LiamGilbertson/MM2SE/README.md

# MM2SE
MendelMax 2.0 Syringe Extruder

The bill of materials and assembly guide can be found in the Documentation folder.

3D models, laser cut patterns and part drawings can be found in the Models folder.

Custom firmware for the optional endstop can be found in the Firmware folder.

Happy making!
