LiamGilbertson/MM2SE/Models/Part Drawings/MM2SE Lead Nut Drawing.JPG

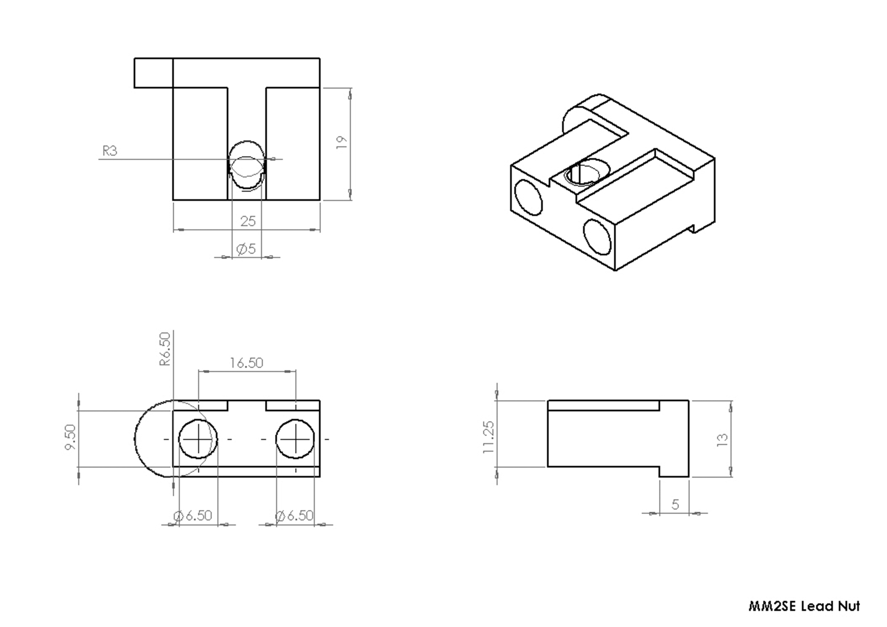
Models/Part Drawings/MM2SE Lead Nut Drawing.JPG
