LiamGilbertson/MM2SE/Models/Part Drawings/MM2SE Rods and Shafts Drawing.JPG

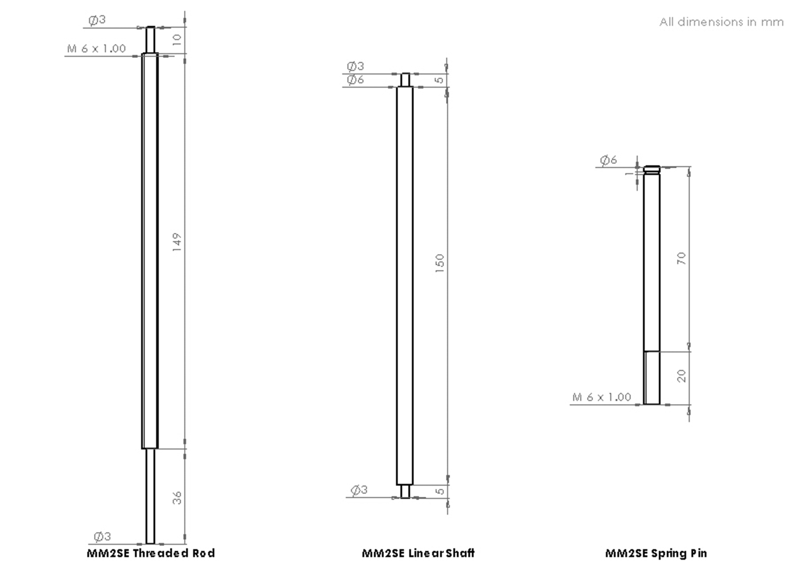
Models/Part Drawings/MM2SE Rods and Shafts Drawing.JPG
