LiamGilbertson/MM2SE/Models/Printed Parts/MM2SE Sliding Press.STL

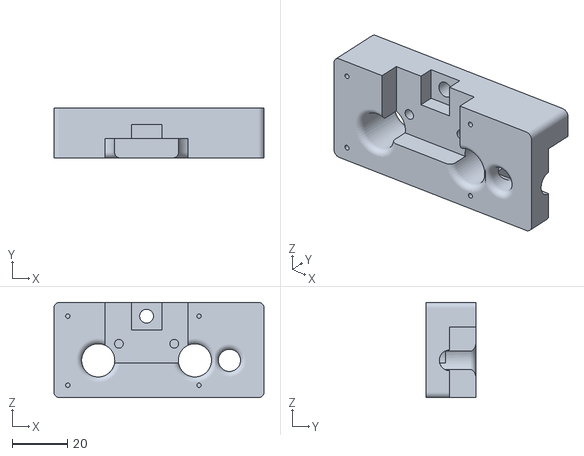
[picture p4: CAD file, 2015-02-28]
Models/Printed Parts/MM2SE Sliding Press.STL
76.0 x 18.0 x 34.5
