LiamGilbertson/MM2SE/Models/Printed Parts/MM2SE Endstop Spacer.STL

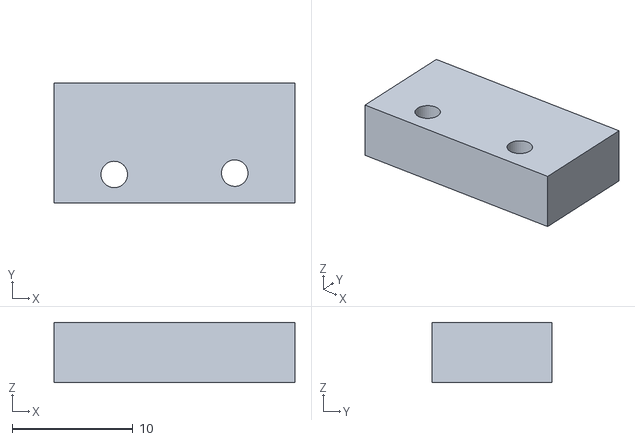
[picture p5: CAD file, 2015-02-26]
Models/Printed Parts/MM2SE Endstop Spacer.STL
20.0 x 10.0 x 5.00
