LiamGilbertson/MM2SE/Models/Printed Parts/MM2SE Spring Clamp.STL

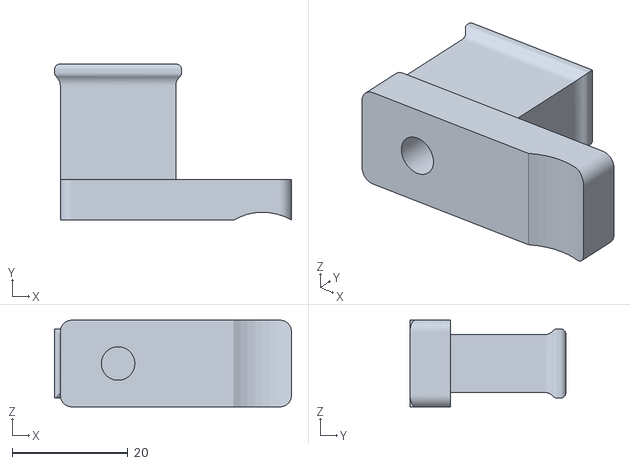
[picture p6: CAD file, 2015-02-26]
Models/Printed Parts/MM2SE Spring Clamp.STL
41.0 x 27.0 x 15.0
