LiamGilbertson/MM2SE/Models/Printed Parts/MM2SE Bottom Mount.STL

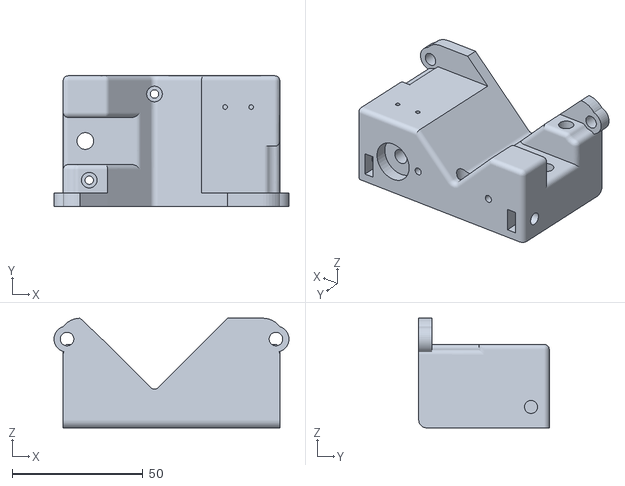
[picture p7: CAD file, 2015-02-26]
Models/Printed Parts/MM2SE Bottom Mount.STL
90.0 x 50.0 x 42.0
