LiamGilbertson/MM2SE/Models/Printed Parts/MM2SE Top Mount.STL

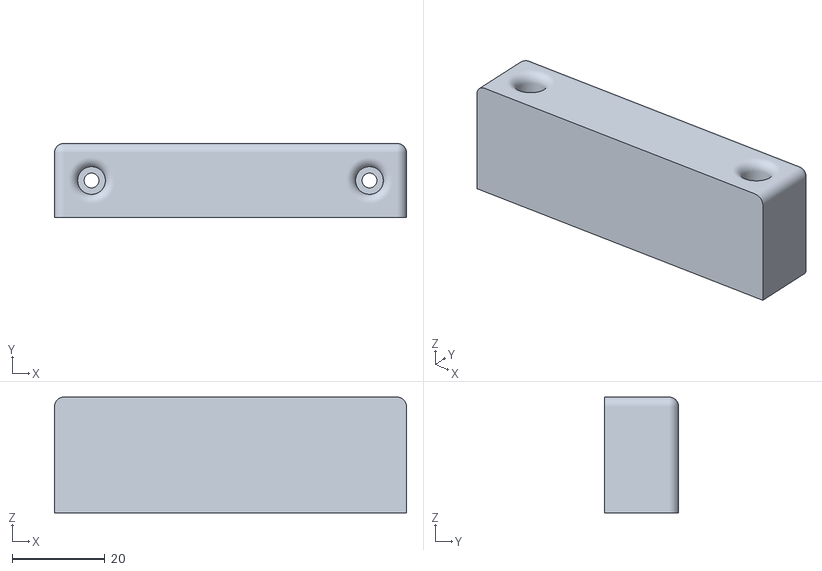
[picture p8: CAD file, 2015-02-26]
Models/Printed Parts/MM2SE Top Mount.STL
76.0 x 16.0 x 25.0
