LiamGilbertson/MM2SE/Documentation/MM2SE Assembly Guide.pdf

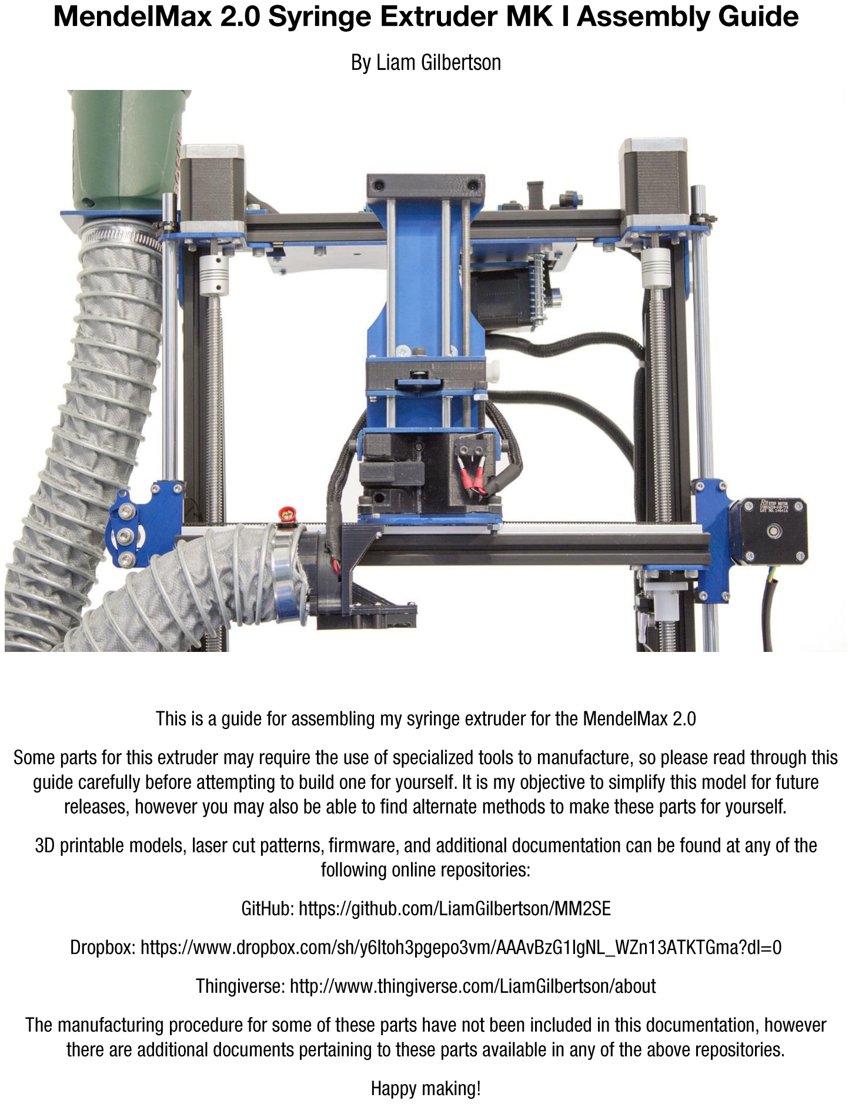
[picture p9: page 1]

Item | Qty | Notes

Water Jet \ Laser Cut Parts
MM2SE Frame | 1 | 3mm Sheet Aluminium, bent as per DXF file. Anodising preferable
MM2SE Lower Syringe Clamp | 1 | 3mm Sheet Aluminium, bent as per DXF file. Anodising preferable
MM2SE Sliding Press Bottom
Plate | 1 | 3mm Sheet Aluminium. Anodising preferable
MM2SE Sliding Press Clamp | 1 | 3mm Sheet Aluminium. Anodising preferable
MM2SE Sliding Press Top Plate | 1 | 3mm Sheet Aluminium. Anodising preferable
MM2SE Stepper Motor Mount | 1 | 3mm Sheet Aluminium, bent as per DXF file. Anodising preferable

3D Printed Parts
MM2SE Top Mount | 1
MM2SE Bottom Mount | 1
MM2SE Sliding Press | 1
MM2SE Spring Clamp | 1
MM2SE Endstop Spacer | 1 | For Optional Endstop

Electronics
Nema 17 Stepper Motor | 1 | May require additional wiring
Endstop | 1 | Optional

Motion
GT2 Pulley + Grub Screws | 2 | 20 Tooth is best, but anything that fits inside the bottom mount will do
GT2 Belt | 1 | 140-GT2 Belt
Ball Bearing | 2 | F605ZZ Flanged Bearing, can be substituted for standard bearing of same dimensions
Linear Bearing | 2 | LM6UU Linear Bearing
Linear Shaft | 3 | M6 Stainless Steel Linear Shaft - 2 x 160mm, 1 x 90mm, as per spec sheet

Threaded Rod | 1 | M6 Stainless Steel Threaded Rod, 195mm, as per spec sheet
Lead Nut | 1 | Acetyl, PTFE or other suitable engineering plastic, as per spec sheet
Compression Spring | 1 | 2in x 0.42in x 0.035in or similar
Compression Spring | 1 | 3\16in x 1-3/8in x 0.016in. Can be substituted for 2 springs half this length

Hardware
M6 External Surclip | 1
M5 x 25 Screws | 1 | For Optional Endstop
M5 x 20 Screws | 3
M5 x 12 Screws | 2
M5 x 12 Countersunk Screws | 4
M5 Washers | 24
M5 Split Washers | 4
M5 x 4 Nuts | 9 | Thickness of 4mm, to fit Lower Syringe Clamp nut traps
M5 External Surclip | 1
M3 x 20 Screws | 2
M3 x 15 Screws | 4
M3 x 8 Screws | 4
M3 x 6 Self Tapping Screws | 8 | If you can't find self-tapping screws, machine screws will do
M3 Washers | 4
M3 Nuts | 4
M2 x 12 Screws | 2 | For Optional Endstop

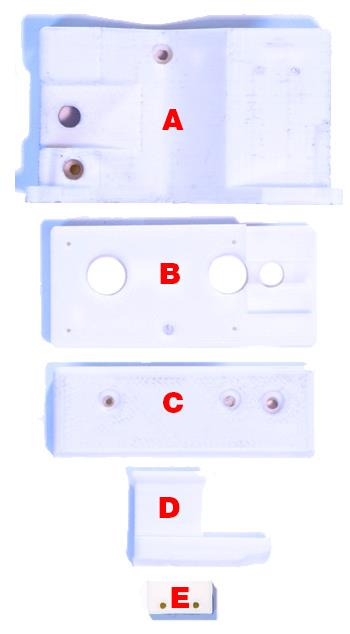
[picture p10: figure]
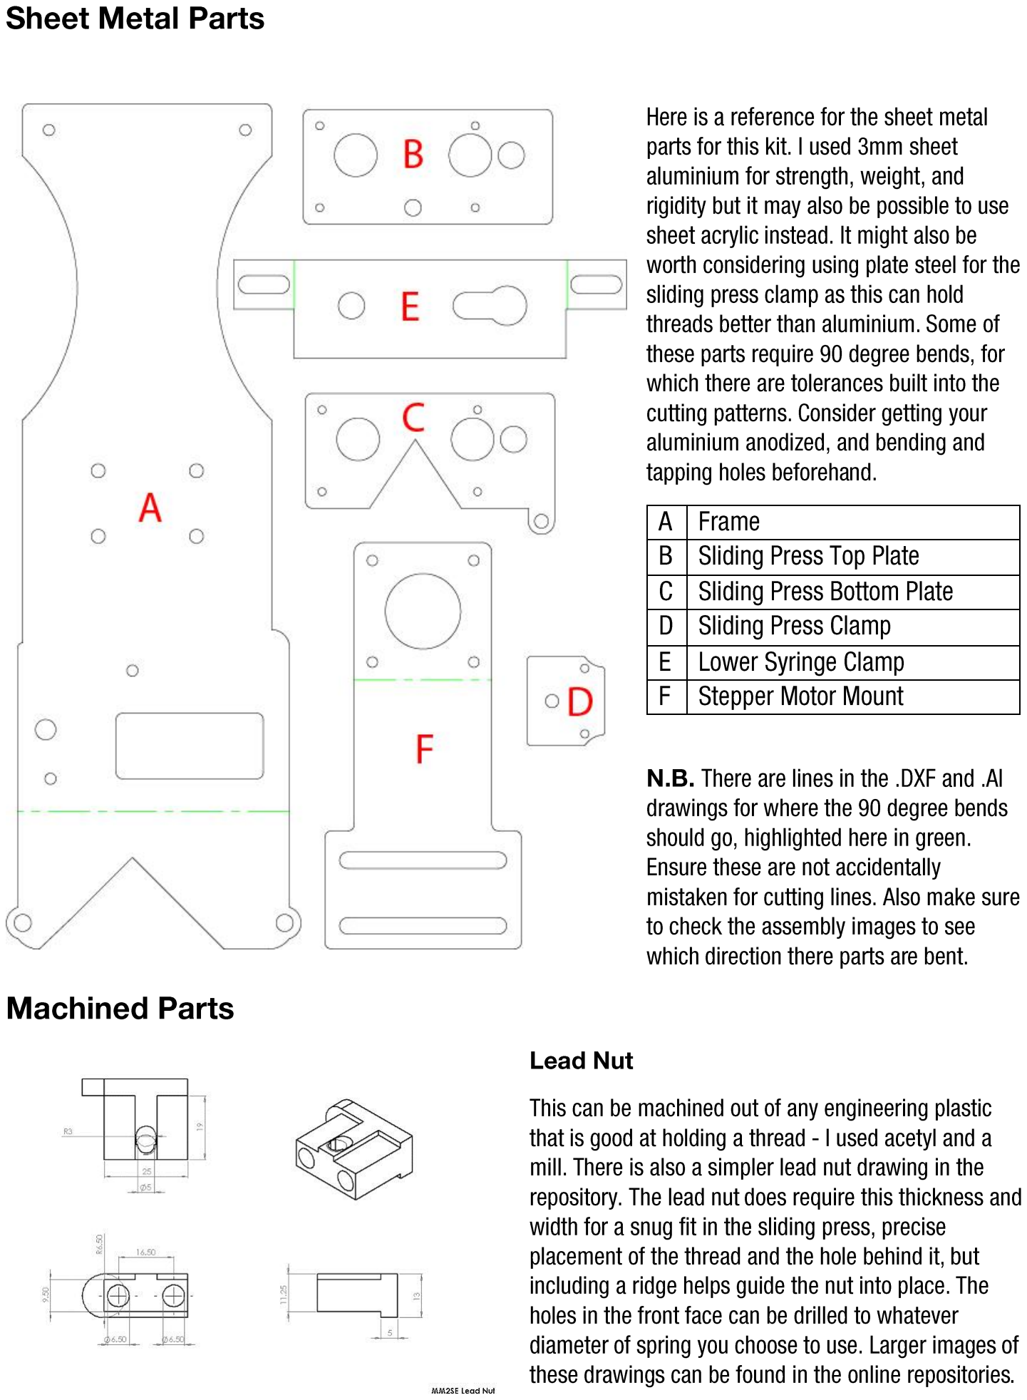
[picture p11: page 4]
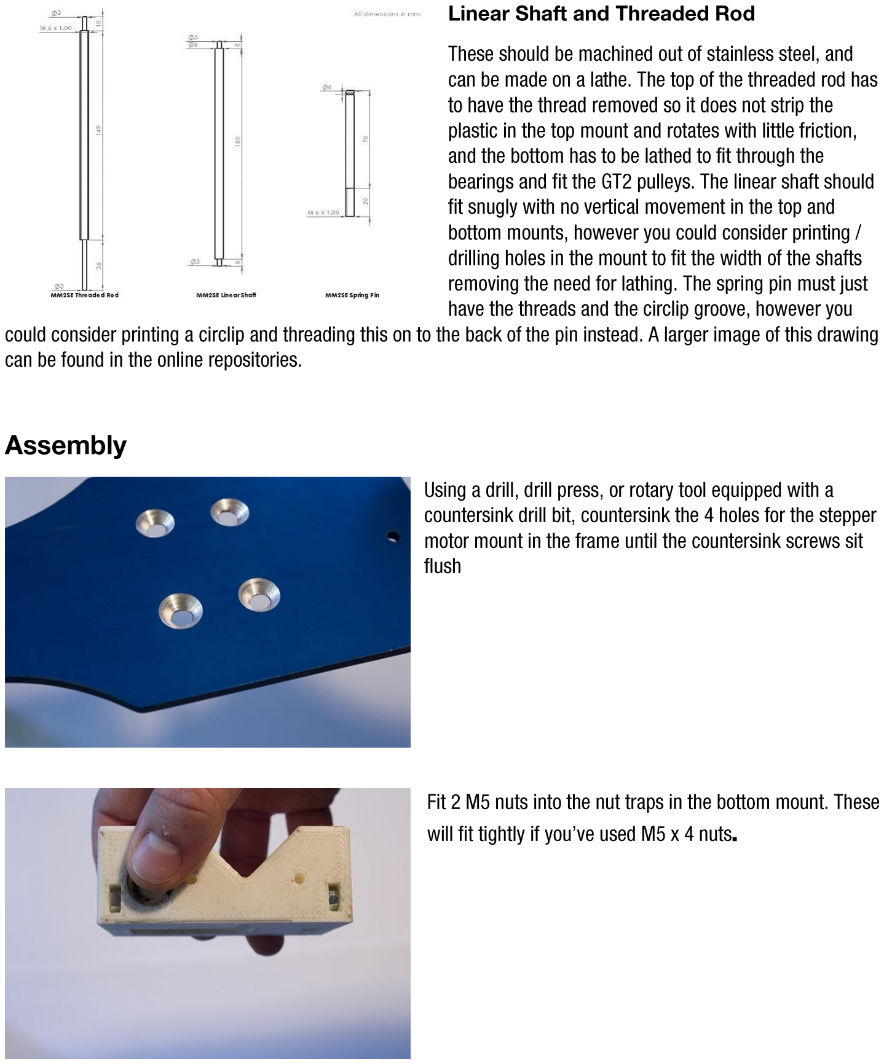
[picture p12: page 5]

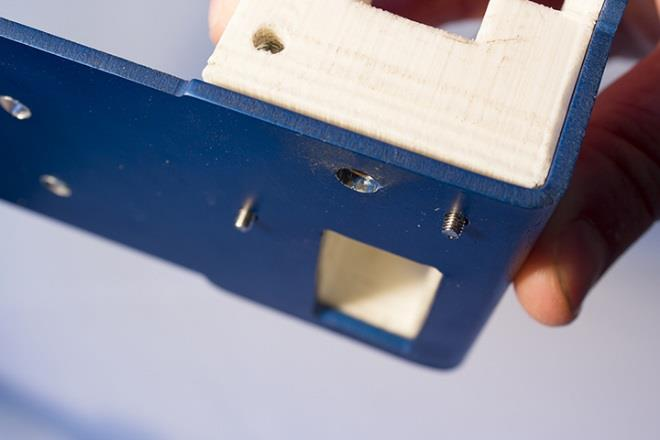
[picture p13: figure]
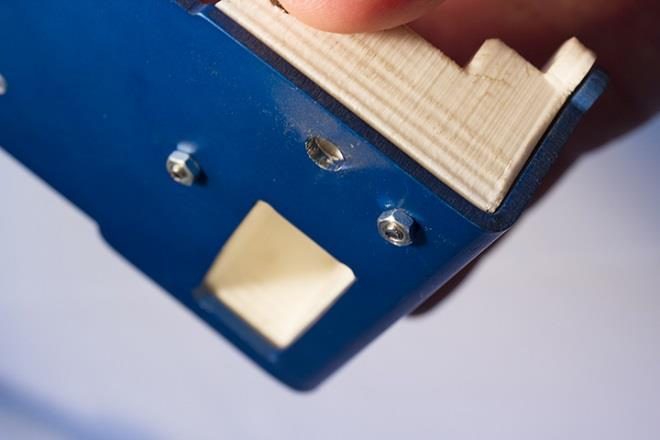
[picture p14: figure]
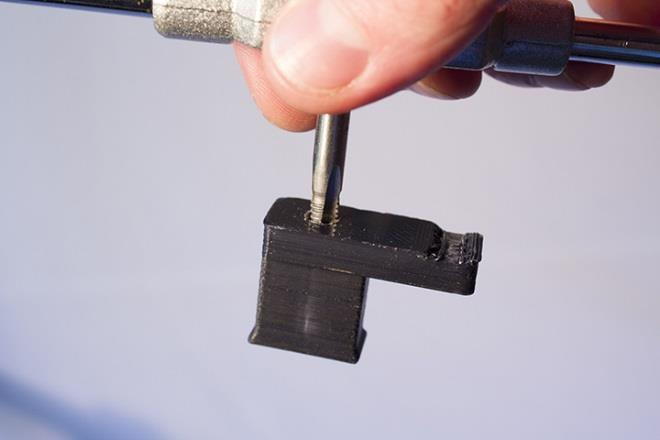
[picture p15: figure]

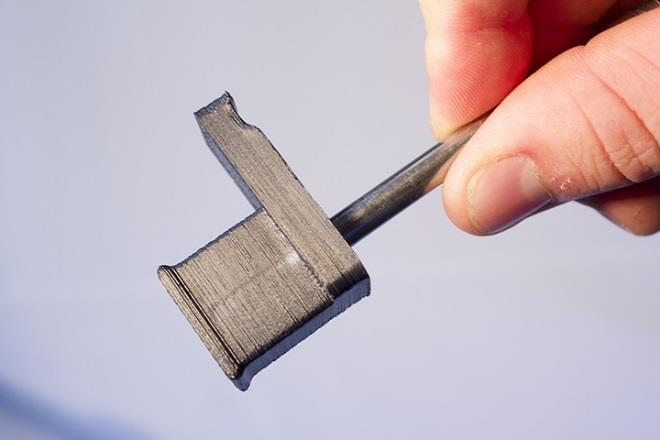
[picture p16: figure]
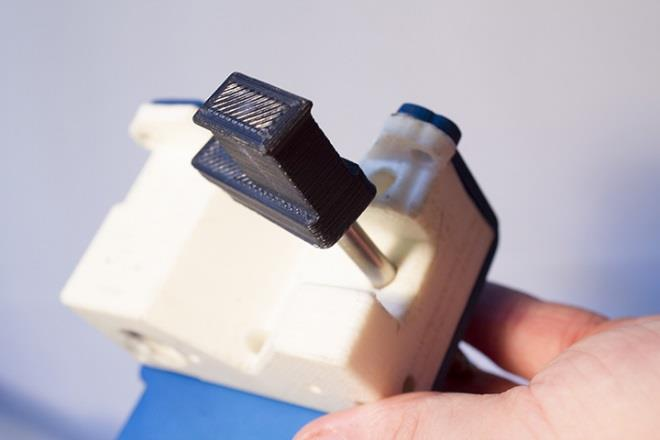
[picture p17: figure]
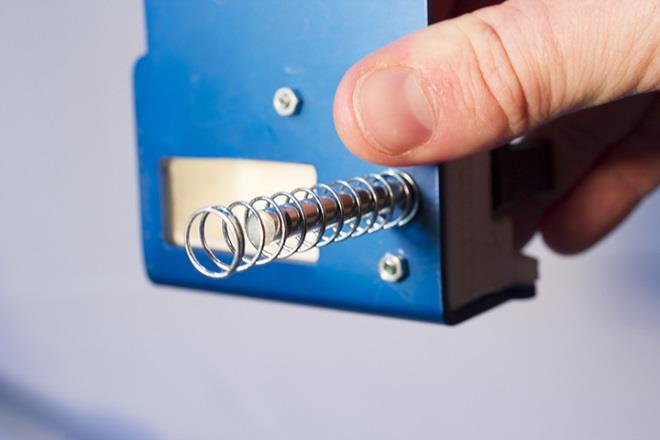
[picture p18: figure]

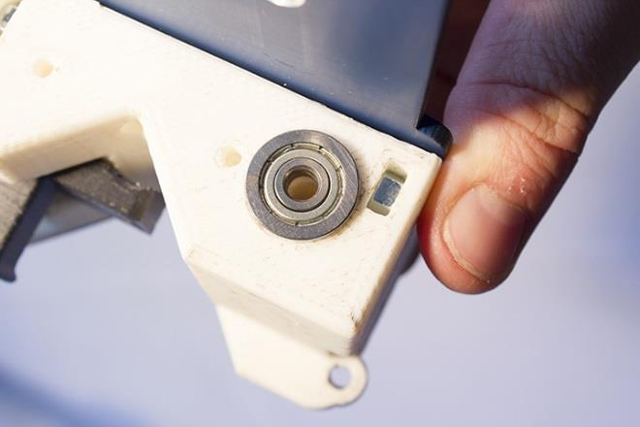
[picture p19: figure]
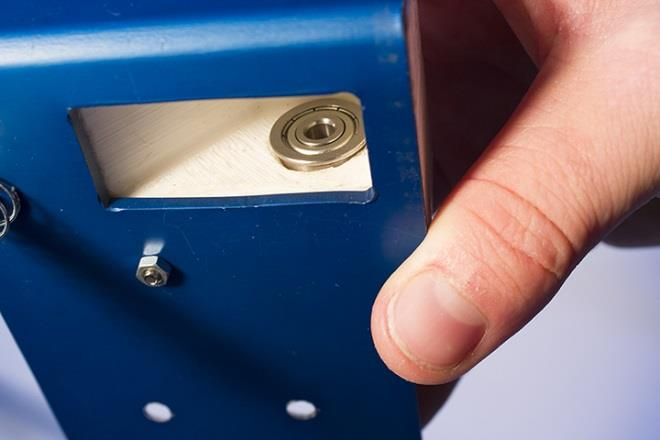
[picture p20: figure]
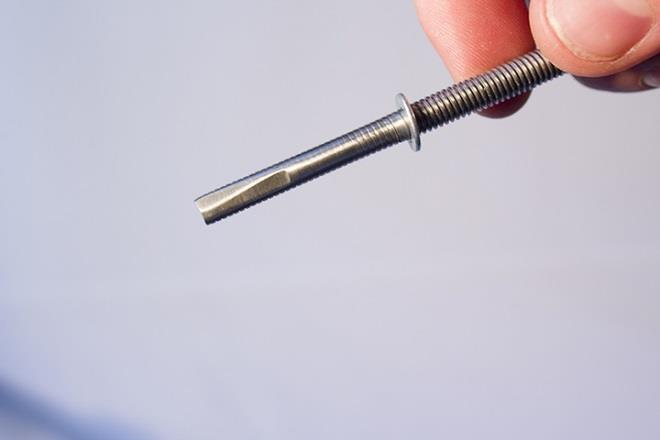
[picture p21: figure]

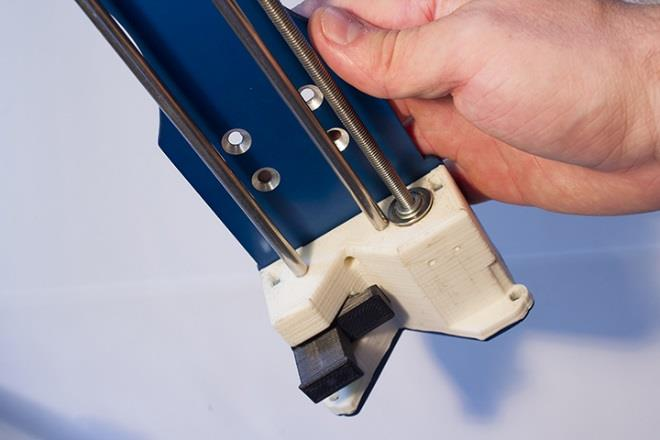
[picture p22: figure]
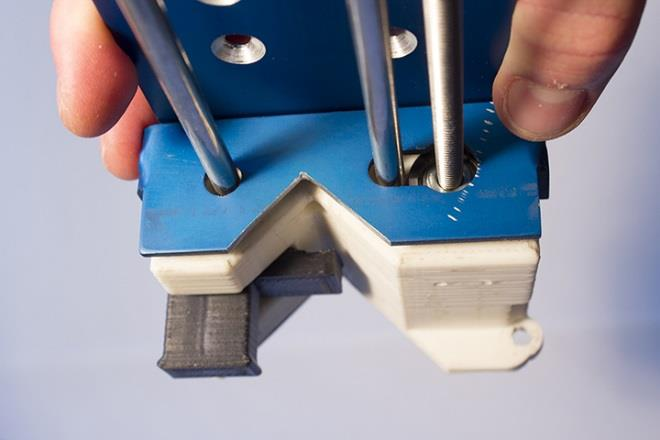
[picture p23: figure]
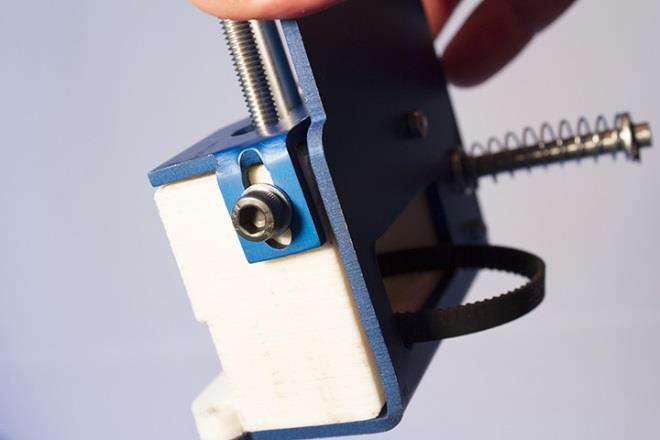
[picture p24: figure]

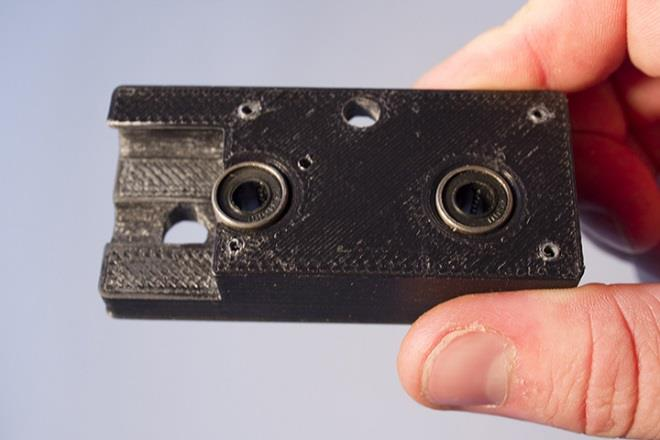
[picture p25: figure]
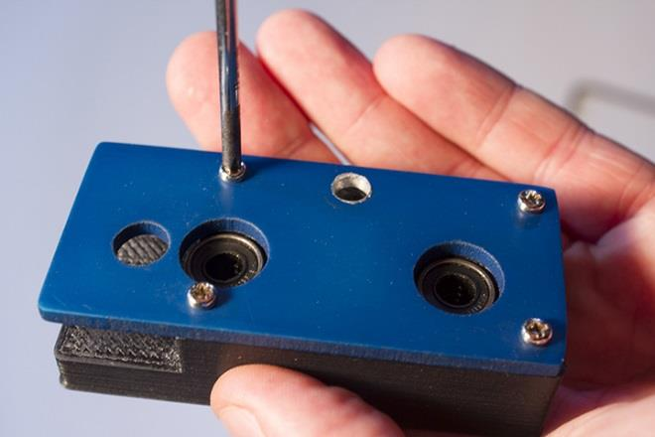
[picture p26: figure]
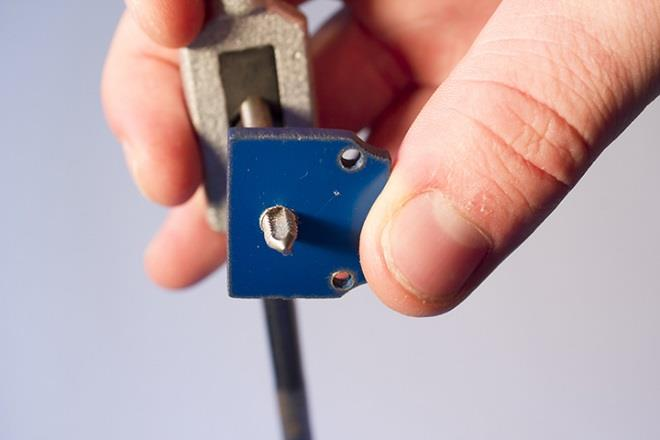
[picture p27: figure]

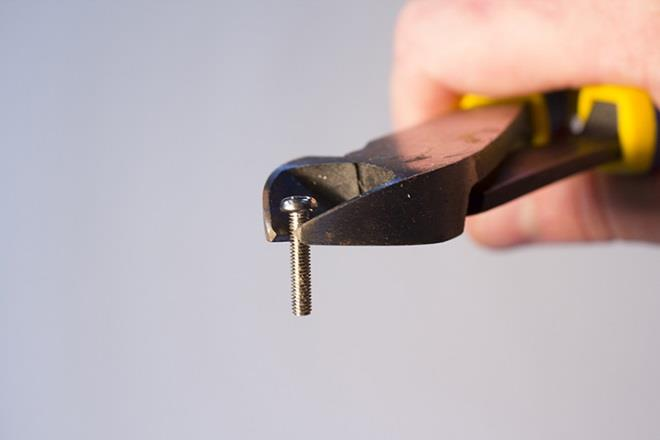
[picture p28: figure]
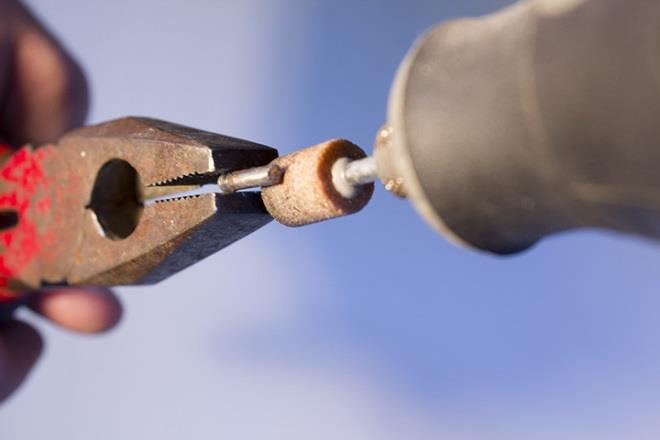
[picture p29: figure]
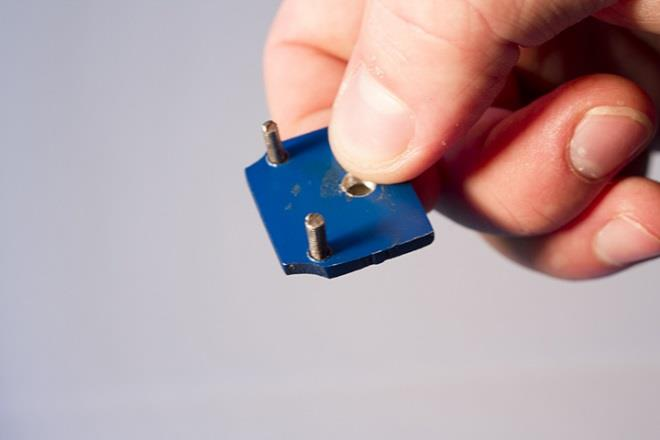
[picture p30: figure]

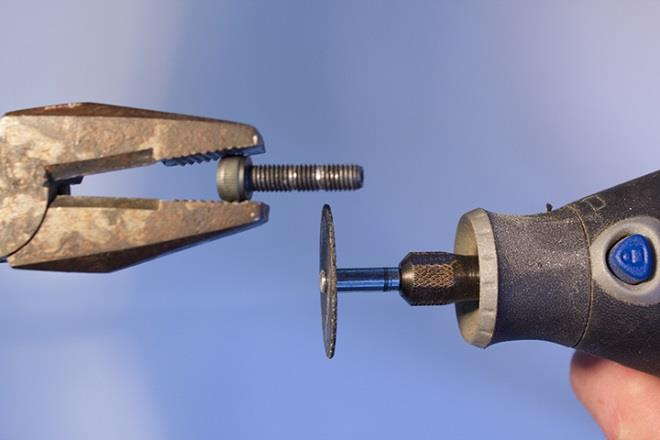
[picture p31: figure]
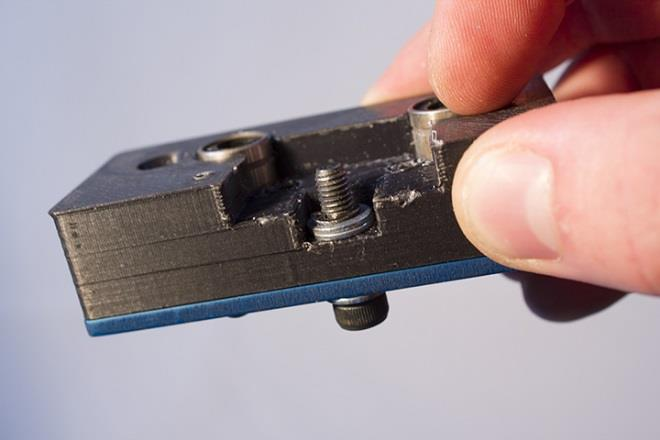
[picture p32: figure]
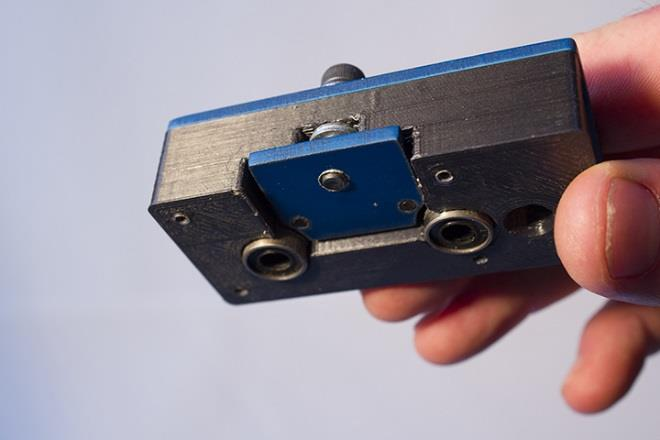
[picture p33: figure]

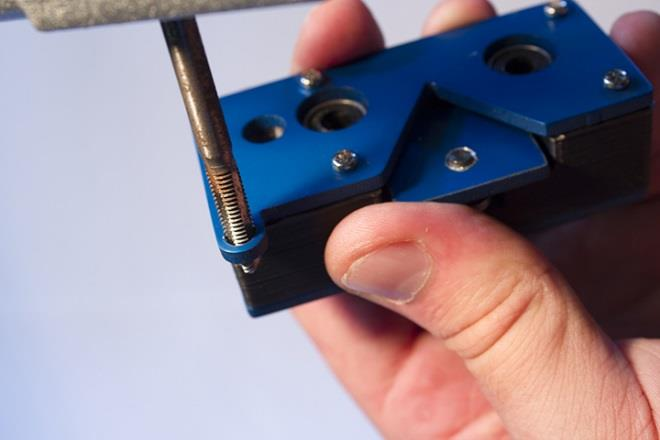
[picture p34: figure]
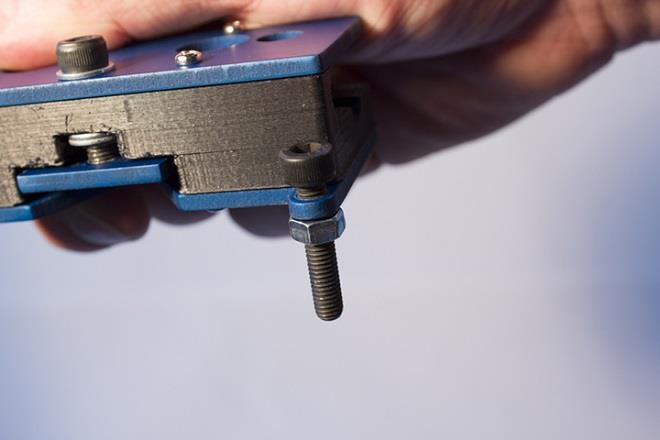
[picture p35: figure]
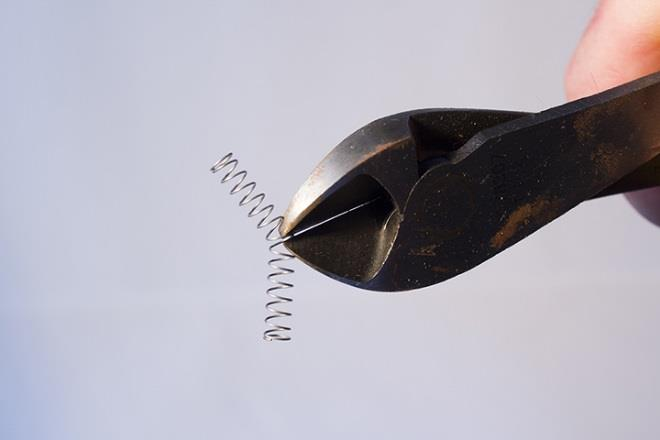
[picture p36: figure]

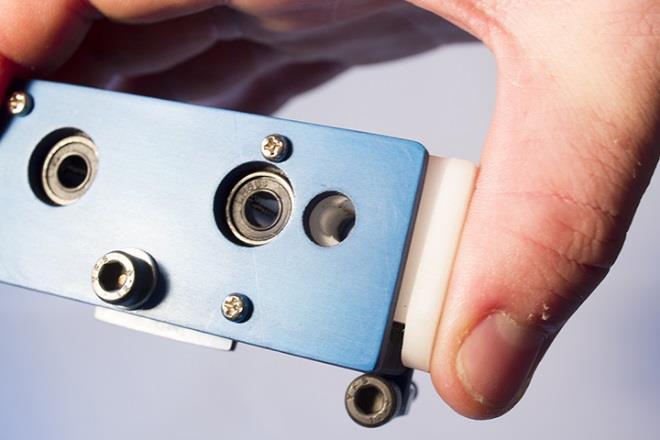
[picture p37: figure]
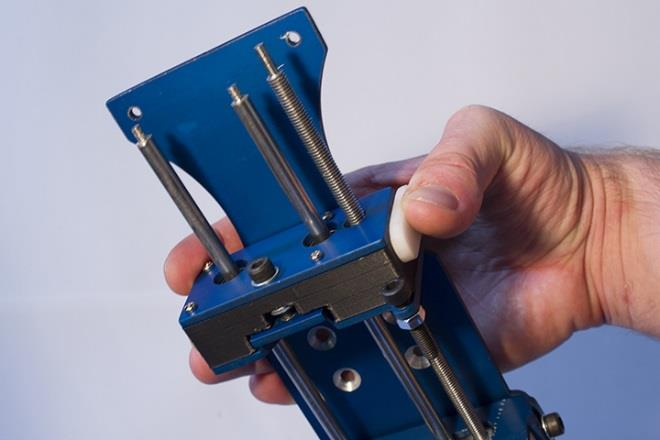
[picture p38: figure]
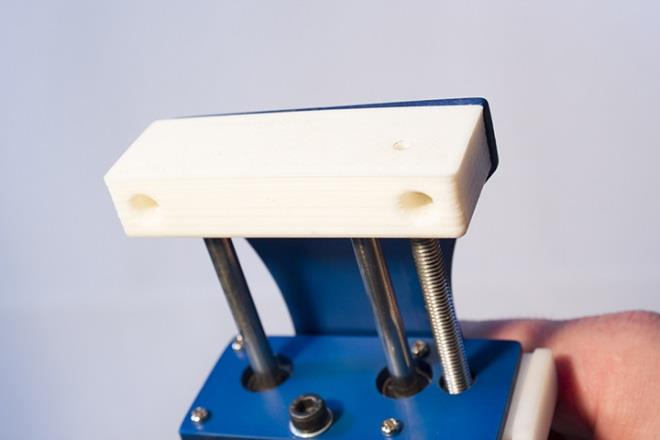
[picture p39: figure]

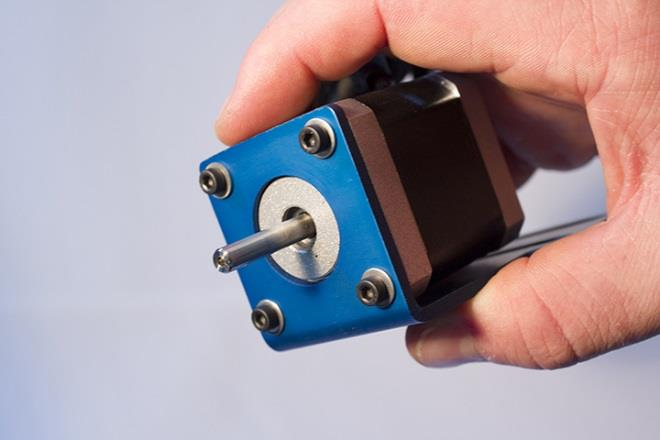
[picture p40: figure]
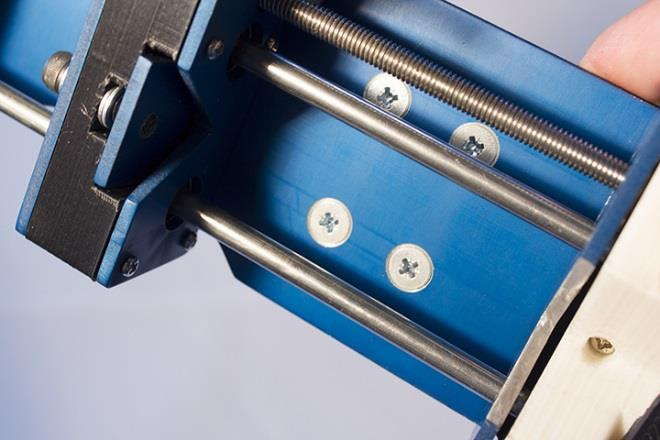
[picture p41: figure]
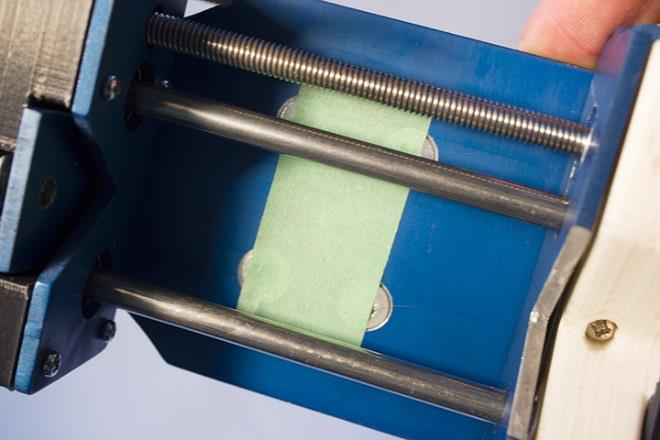
[picture p42: figure]

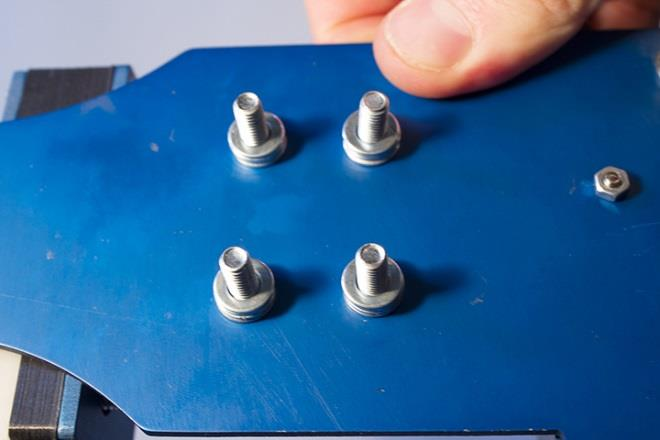
[picture p43: figure]
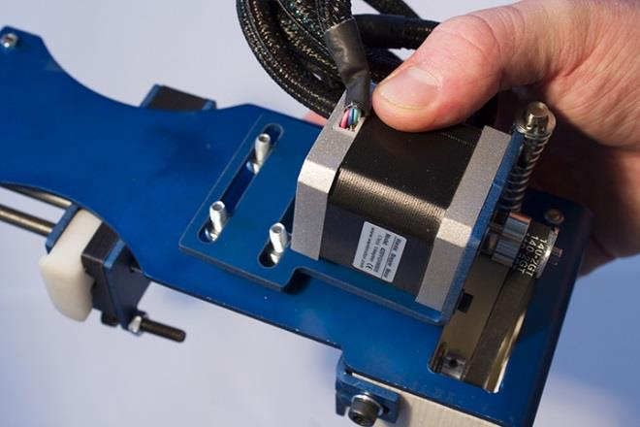
[picture p44: figure]
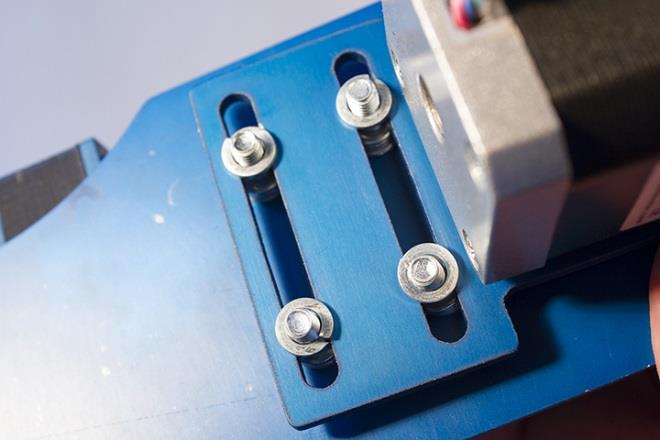
[picture p45: figure]

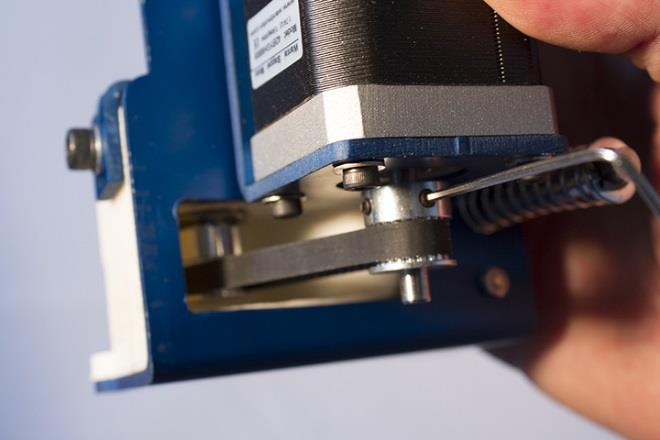
[picture p46: figure]
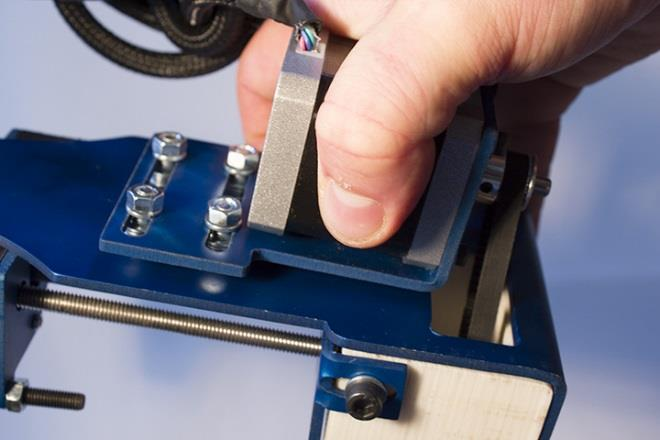
[picture p47: figure]
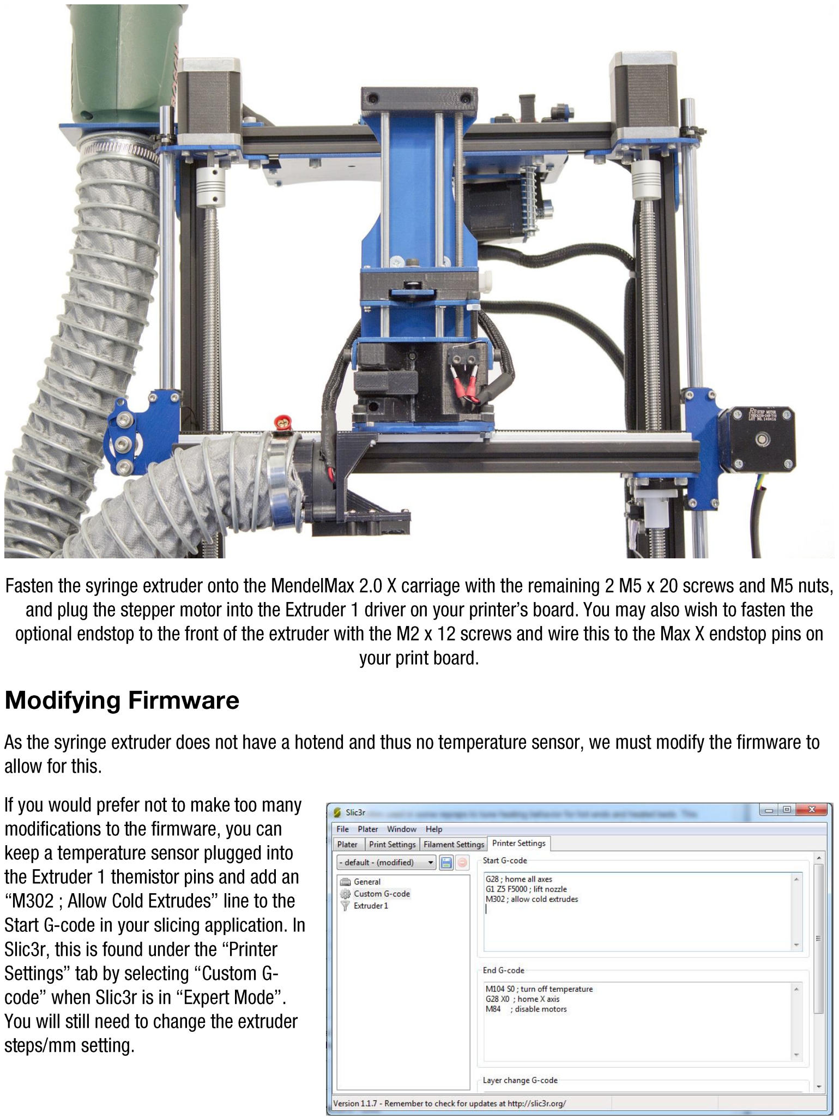
[picture p48: page 18]
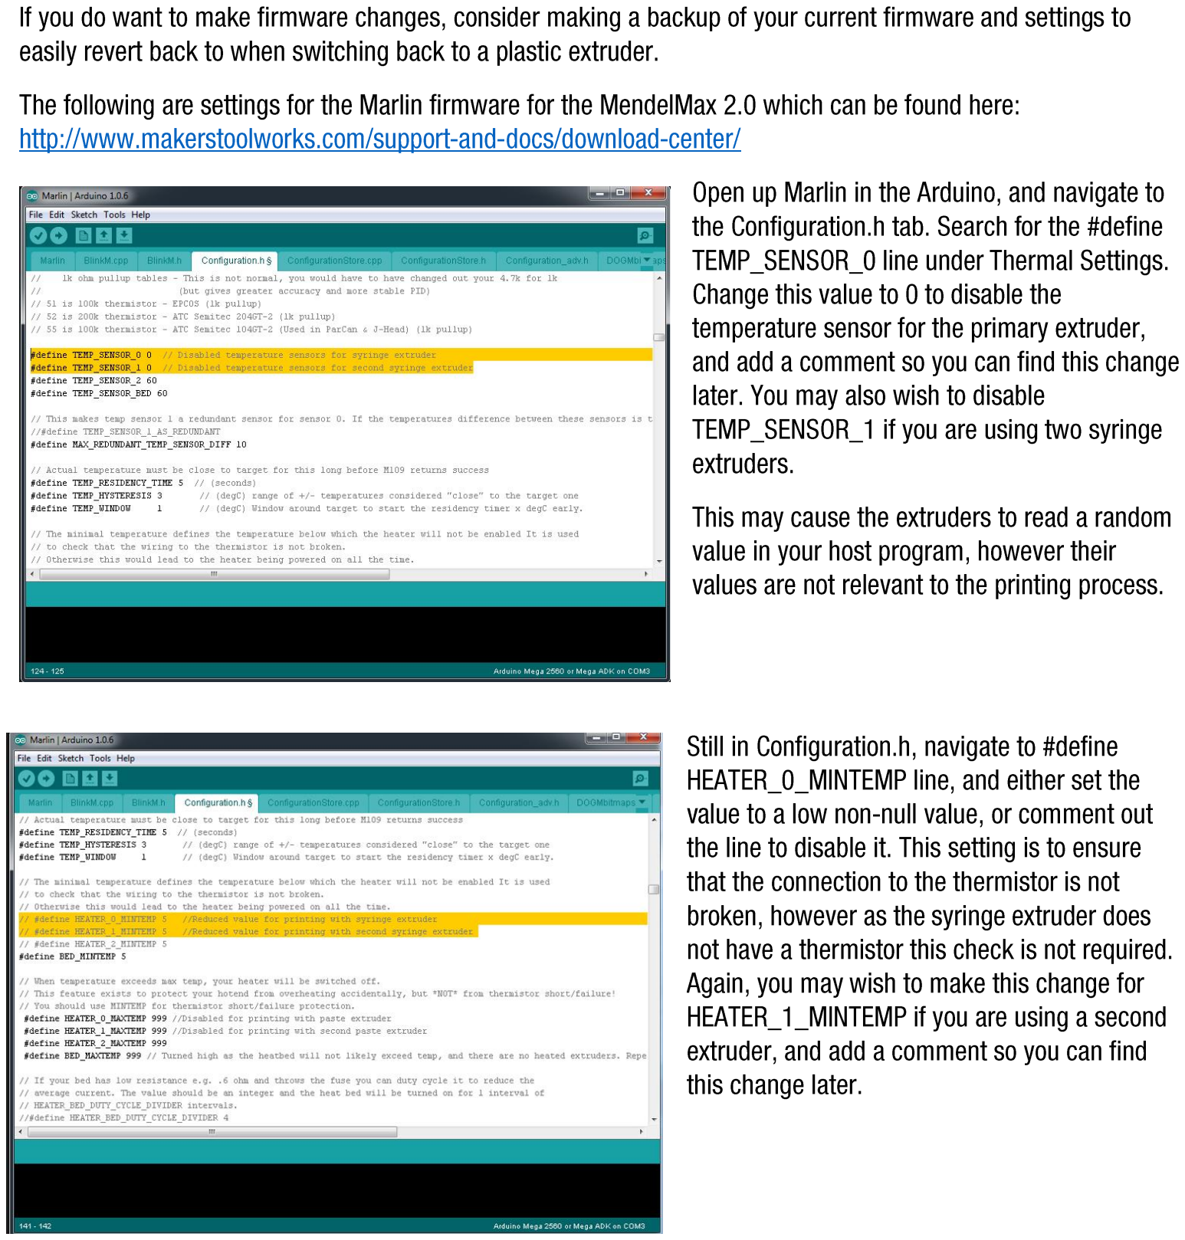
[picture p49: page 19]
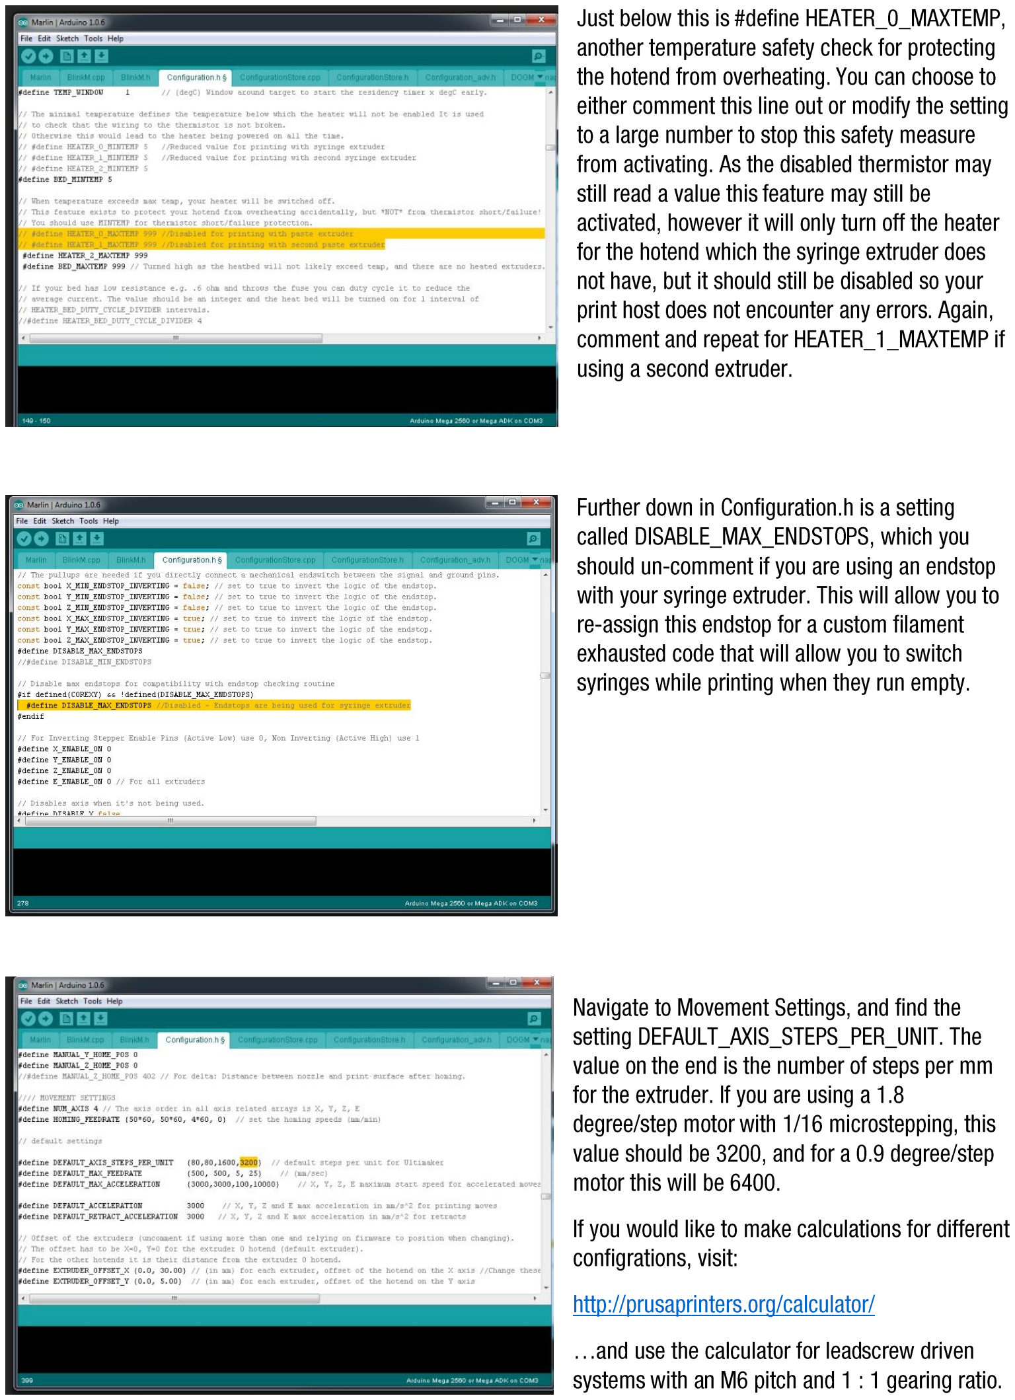
[picture p50: page 20]
