LiamGilbertson/MM2SE/(commit log)

2015-02-26 Initial commit for MendelMax 2.0 Syringe Pump
    [MM2SE Bottom Mount.STL, MM2SE Endstop Spacer.STL, MM2SE MK1 BOM.xlsx, MM2SE Sliding Press.STL, MM2SE Spring Clamp.STL, MM2SE Top Mount.STL]
2015-02-28 Uploading more files
    [MM2SE MK1 BOM.xlsx, MM2SE Sliding Press.STL]
